andrew-jacobs/rgb-clock/(commit log)

2017-09-25 Started on schematic
    [RGB LED Clock.sch]
2017-11-03 Added timer
    [RGB LED Clock.sch]
2019-12-03 Snapshot with I2C
    [RGB LED Clock.sch]
2019-12-23 Change switch sampling. Added theme changing.
